biagiom/QuakeSense/(commit log)

2018-01-07 Add the project report and Arduino sketches for Node and Gateway
2018-02-04 Update QuakeSense_Gateway.ino and QuakeSense_Gateway_ACK.ino sketches
    Fix printing of BSSID and MAC on the Serial Monitor
    [QuakeSense_Gateway.ino]
2018-02-12 Add two new sketches for Node
    Add QuakeSense_Node_LowPower.ino and QuakeSense_Node_LowPower_TinyGPS.ino
    sketches for Node in order to use its low power capabilities
2018-03-09 Rework sketches related to sensor node and LoRa gateway
    [QuakeSense_Gateway.ino]
2018-03-26 Improve sketches related to Sensor Node
    Improve QuakeSense_Node.ino and QuakeSense_Node_UniformDuration.ino sketches
2018-03-28 Update documentation of sketches related to Sensor Node and Gateway
2018-05-27 Fix typo of sketches related to sensor node
    [QuakeSense_Node.ino]
2018-08-26 Update sketches related to Sensor Node and Gateway
    - Improve LoRa EAM and EDP formats
    - Update documentation
    - Improve the gateway's method used to parse LoRa packets
